alanbuep/ProyectoFinal-IngElectronica/Circuito_esquematico/sch_smd_final.pdf

10nF 1 2

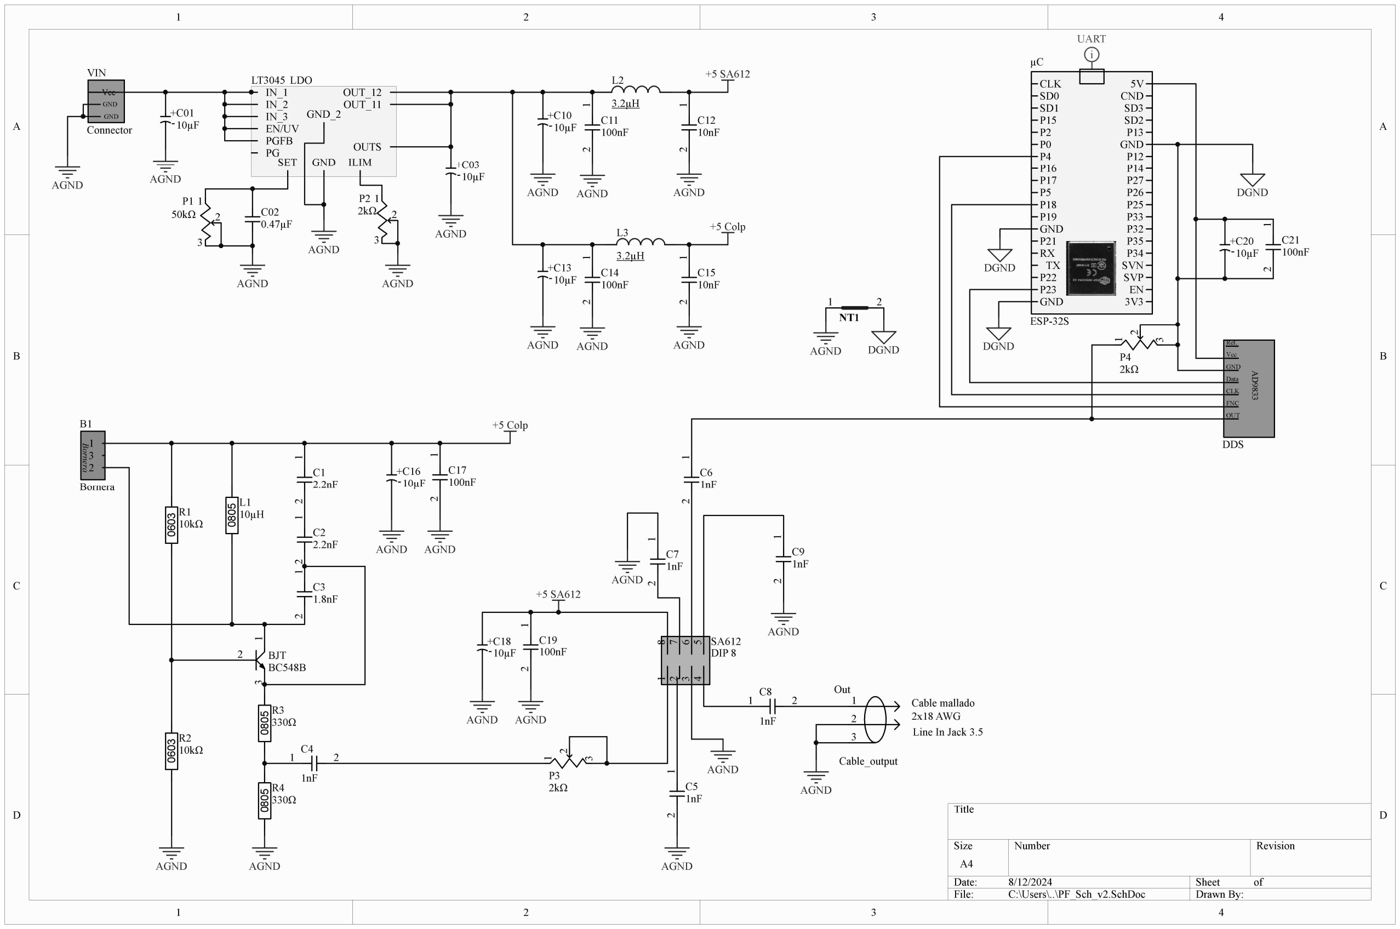
[picture p1: page 1]

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
Title

Size | Number | | Revision
A4
Date: | 8/12/2024 | Sheet | of
File: | C:\Users\..\PF_Sch_v2.SchDoc | Drawn By:

1
2 3
BJT

# BC548B ⁰⁸⁰⁵L1

10µH 1 2
C1
2.2nF 1 2

C2

# 2.2nF 0805R3

330Ω 0805R4

330Ω

1 2

C4

1nF | 1 2
C5
1nF

AGND

AGND | AGND | AGND

1 2
C6
1nF

1 2
C11
100nF

+5 SA612

+5 SA612

AGND

AGND

AGND | AGND | AGND 1 2

C14
100nF

+5 Colp

AGND | AGND | AGND

+5 Colp

2x18 AWG
Line In Jack 3.5

AGND

Cable mallado

i

UART

DGND

1 2
C9
1nF

AGND ¹ ²
C7
1nF
AGND

1 2

C8

1nF

DGND

+

C16

10µF ¹ 2
C17
100nF

AGND AGND

+

C18

10µF ¹ 2
C19
100nF

AGND AGND

+

C13
10µF

+

C10
10µF

Ref.
Vcc
GND
Data
CLK
FNC

OUT AD9833

DDS 8

7

6

5

1

2

3

4

SA612
DIP 8

1
2Bornera 3

B1

Bornera

IN_1
IN_2
IN_3
EN/UV

PG
ILIM

PGFB

SET GND

OUTS

OUT_11

OUT_12

GND_2

LT3045 LDO

AGND

C02
0.47µF

AGND

AGND

+

C01
10µF

+

C03
10µF

1
2

3

P1
50kΩ

1
2

3

P2
2kΩ

AGND

1

2
3
P3
2kΩ

+

C20

10µF ¹ 2
C21
100nF

1 2
NT1

AGND

1
2
3

Out

Cable_output

1 2
C12

C15
10nF 0603R1

# 10kΩ 0603R2

10kΩ

3.2µH

L2

3.2µH

L3 | 1

2
3
P4
2kΩ 1 2

C3
1.8nF

Vcc
GND
GND

VIN

Connector

DGND

DGND

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
CLK | 5V
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
ESP-32S
